IshraqueSarwar/fc_ee-26/references/MCU.jpg

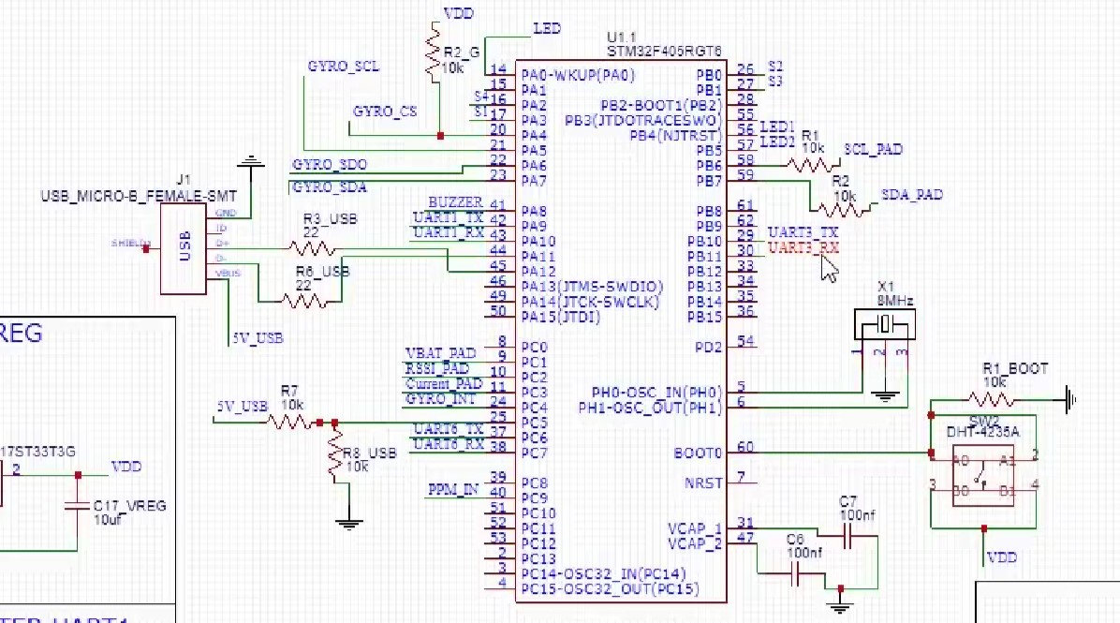
references/MCU.jpg
