IshraqueSarwar/fc_ee-26/references/9250-min-circuit.jpg

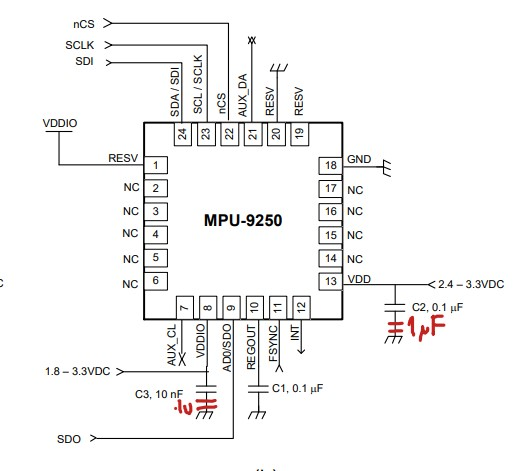
references/9250-min-circuit.jpg
