IshraqueSarwar/fc_ee-26/references/MCU_power.jpg

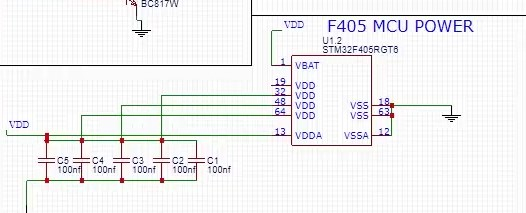
references/MCU_power.jpg
