IshraqueSarwar/fc_ee-26/references/MPU6000.jpg

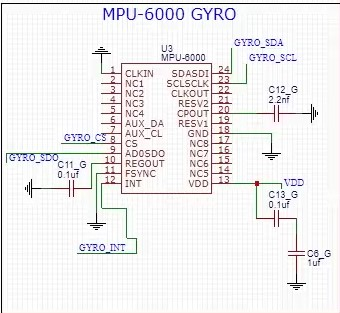
references/MPU6000.jpg
