IshraqueSarwar/fc_ee-26/references/STM32F407VET6_pin_def.jpg

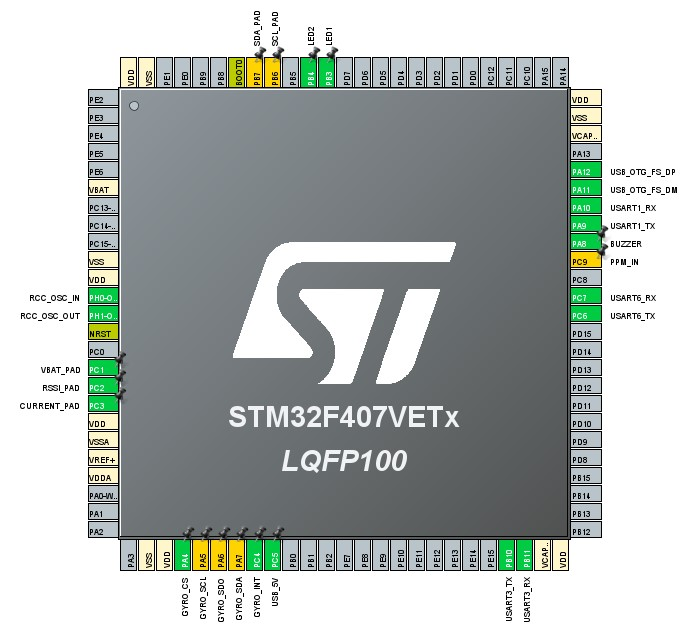
references/STM32F407VET6_pin_def.jpg
