IshraqueSarwar/fc_ee-26/schematics/fc-ee/fc-ee.kicad_pcb

## KiCad design schematics/fc-ee/fc-ee.kicad_pcb (2026-03-01)

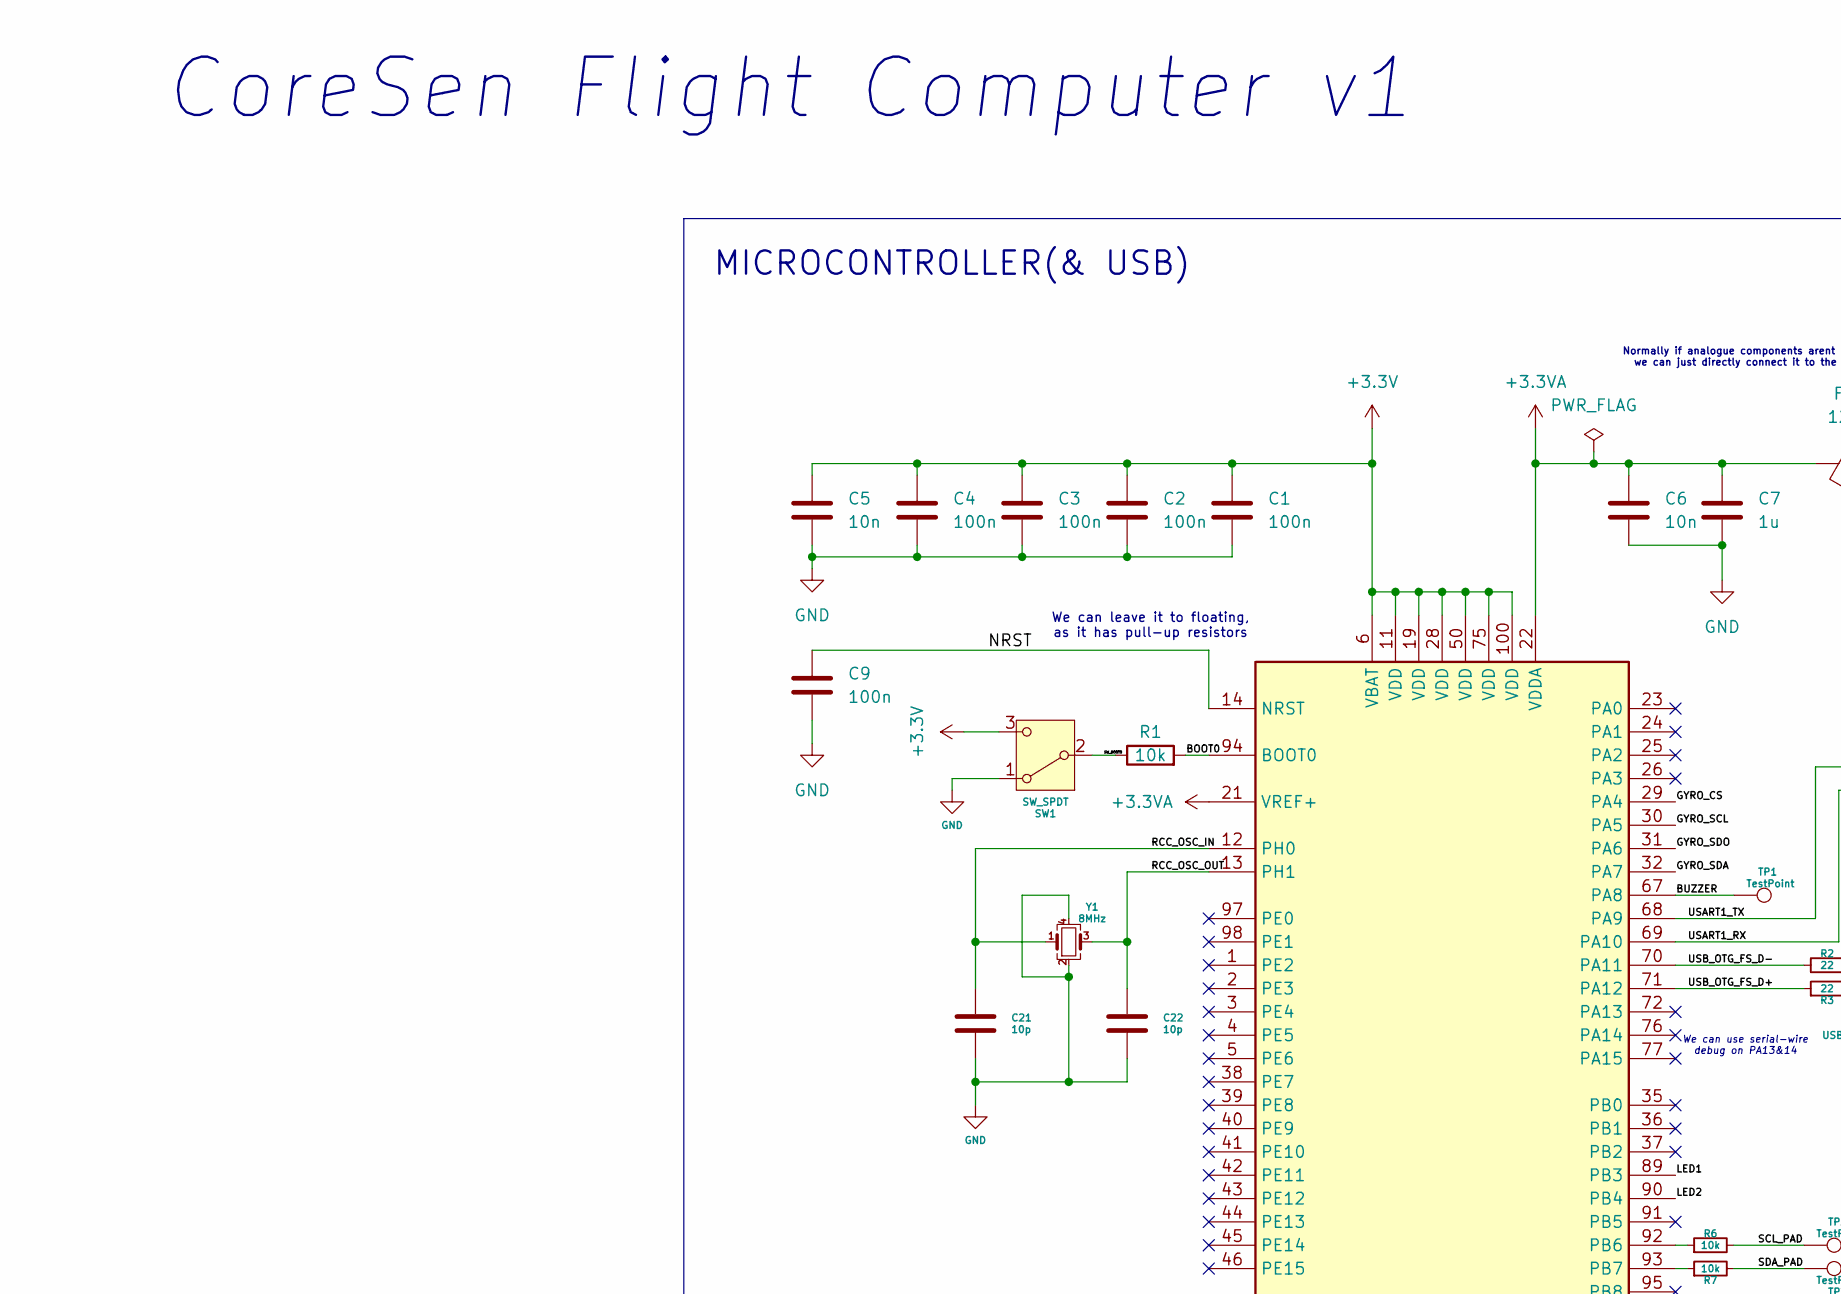
[picture p18: schematic fc-ee.kicad_sch, CoreSen-FC1, part in row 1, column 1]

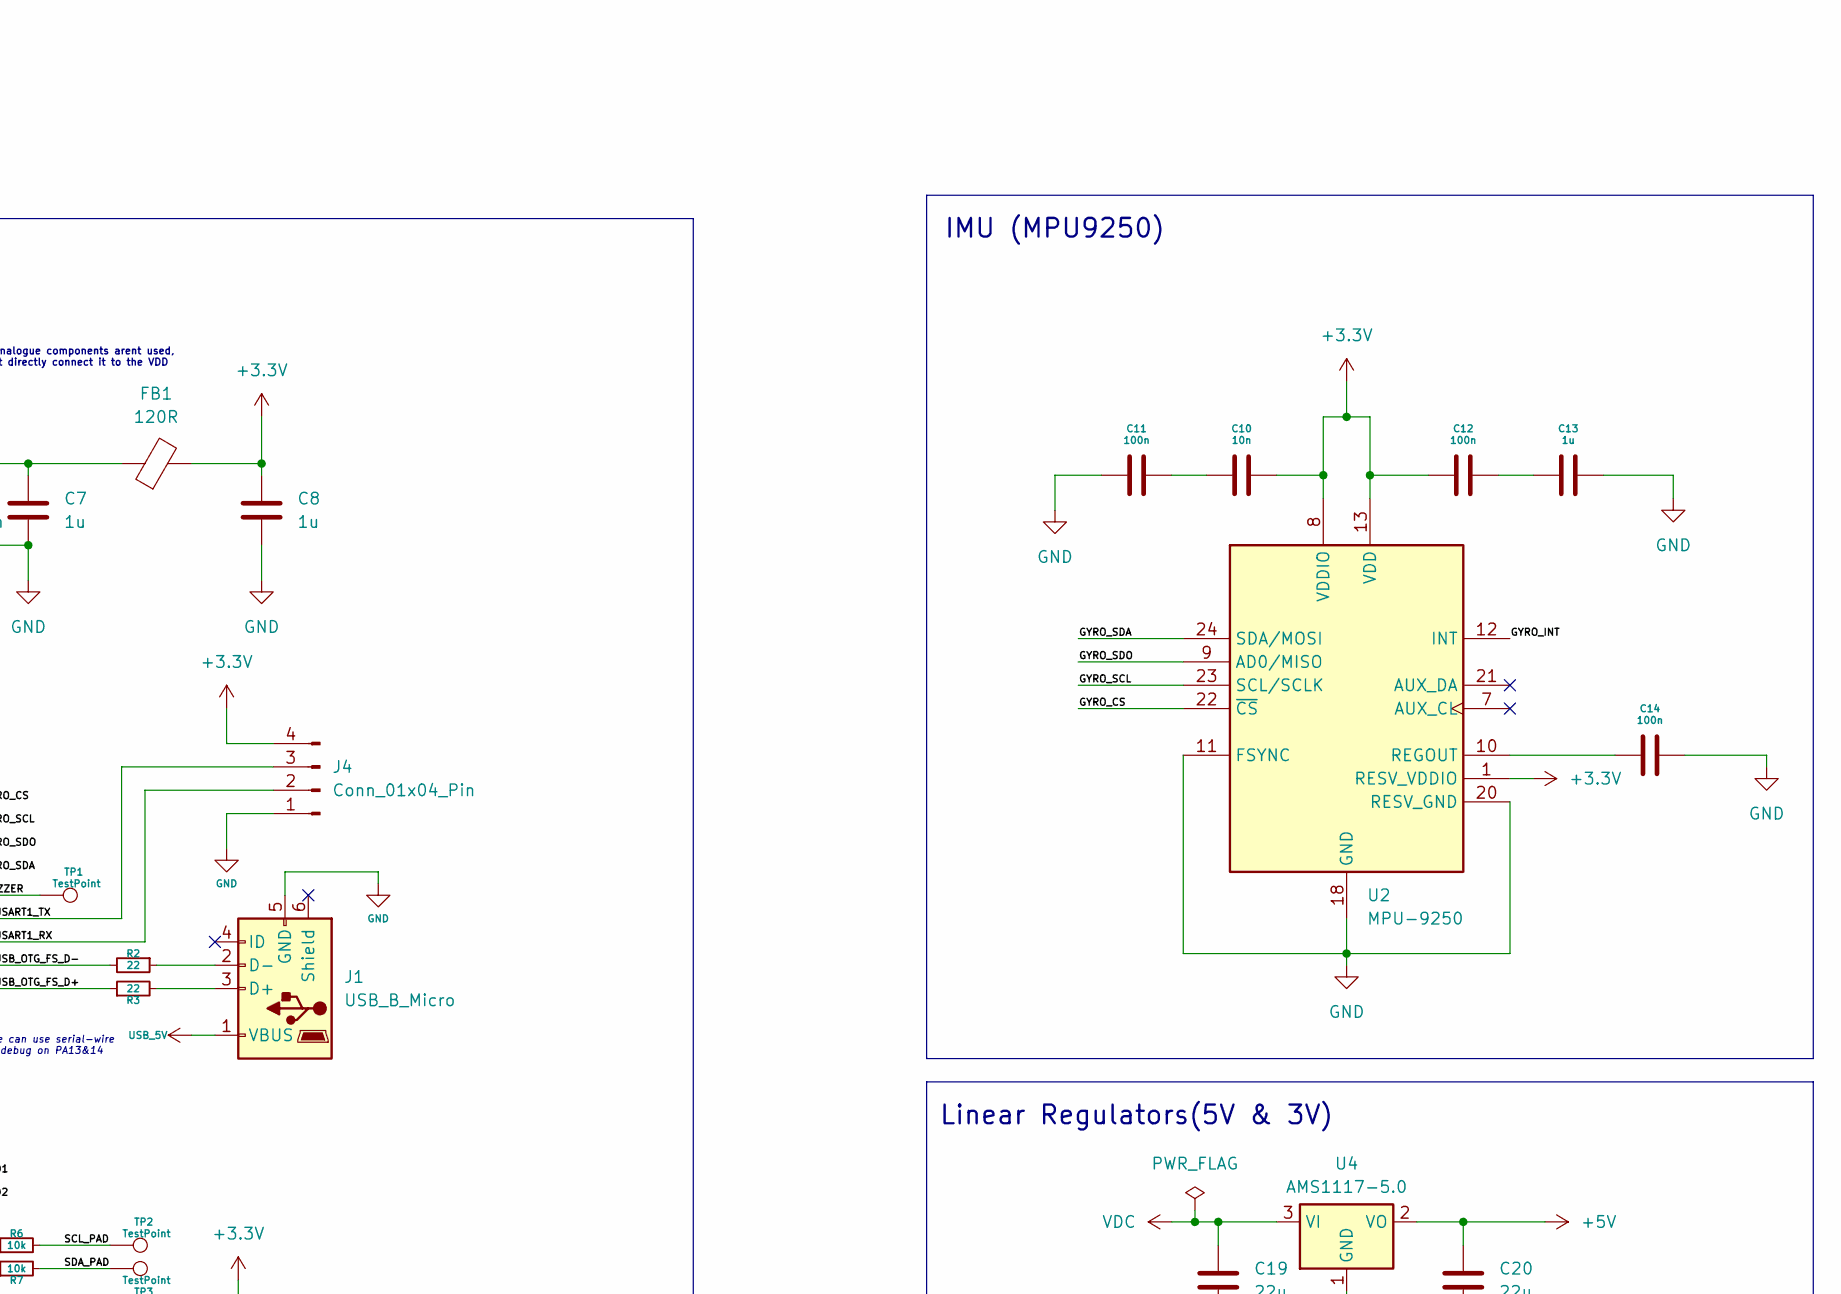
[picture p19: schematic fc-ee.kicad_sch, CoreSen-FC1, part in row 1, column 2]

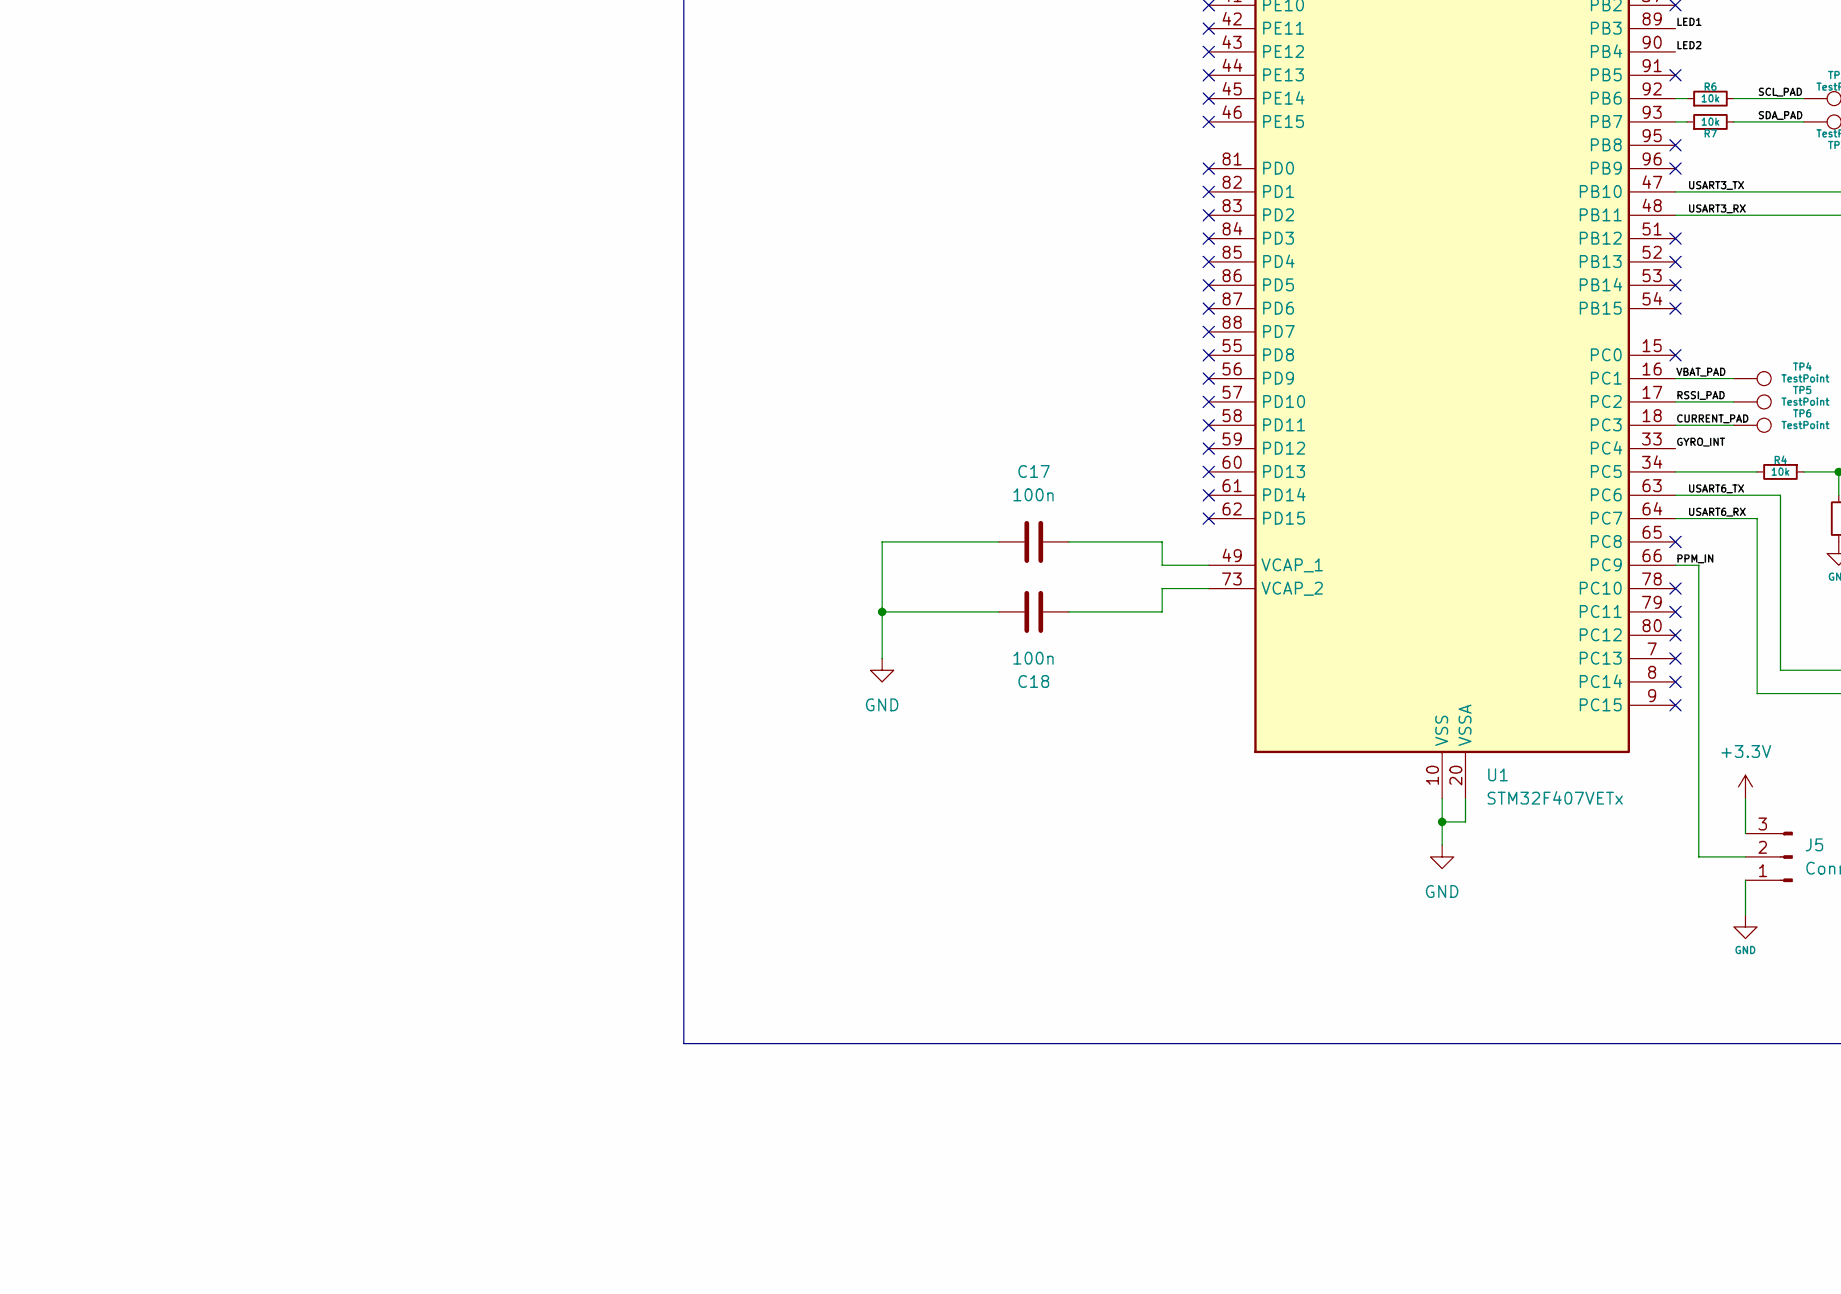
[picture p20: schematic fc-ee.kicad_sch, CoreSen-FC1, part in row 2, column 1]

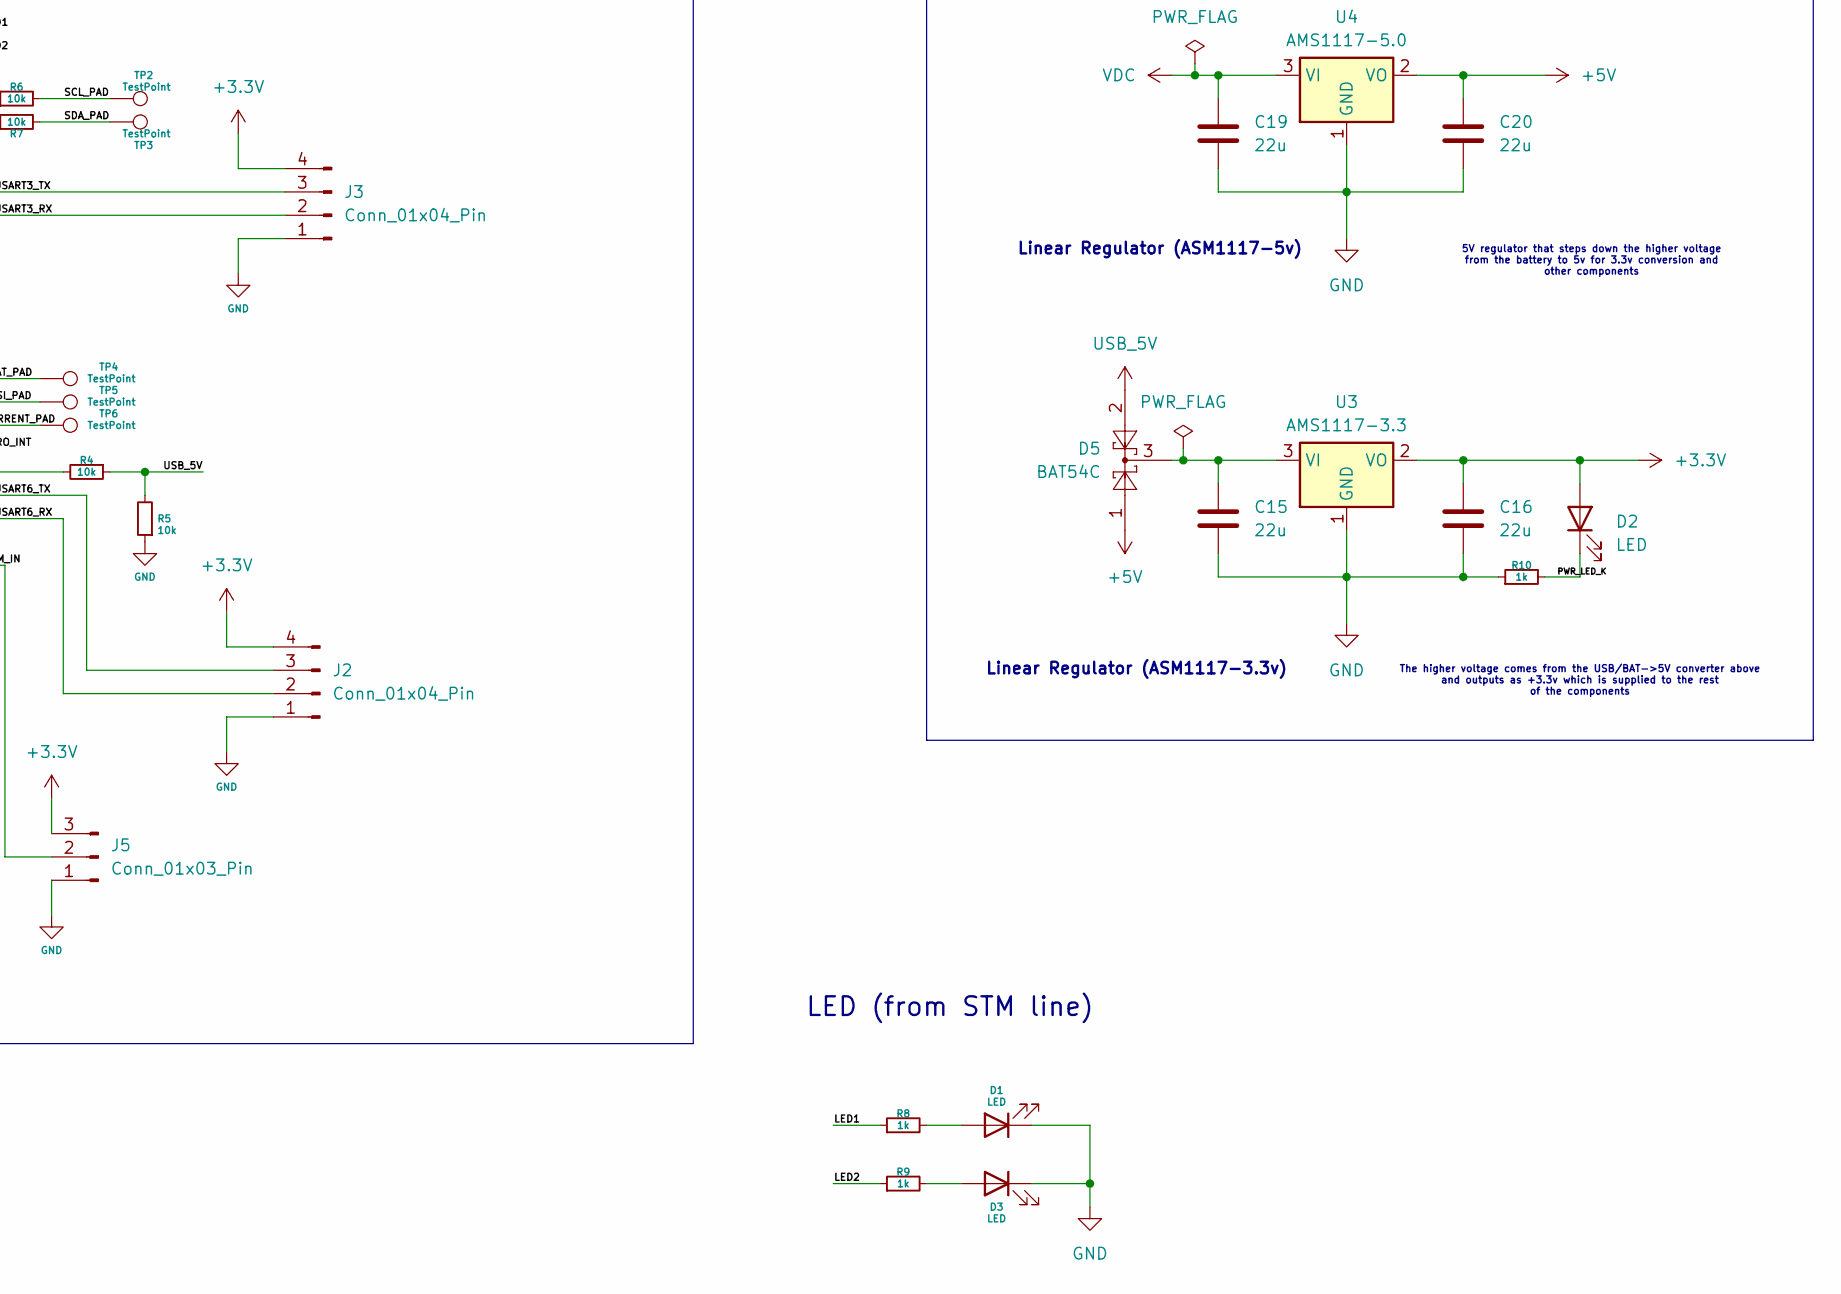
[picture p21: schematic fc-ee.kicad_sch, CoreSen-FC1, part in row 2, column 2]

Parts:
C1, C2, C3, C4, C9, C11, C12, C14, C17, C18: 100n; C_0402_1005Metric
C5, C6, C10: 10n; C_0603_1608Metric
C7, C8, C13: 1u; C_0402_1005Metric
C15, C16, C19, C20: 22u; C_0805_2012Metric
C21, C22: 10p; C_0603_1608Metric
D1, D2, D3: LED; LED_0201_0603Metric
D5: BAT54C; SOT-23
FB1: 120R; L_0603_1608Metric
J1: USB_B_Micro; USB_Micro-B_Molex_47346-0001
J2, J3, J4: Conn_01x04_Pin; PinHeader_1x04_P2.00mm_Vertical
J5: Conn_01x03_Pin; JST_NV_B03P-NV_1x03_P5.00mm_Vertical
R1, R4, R5, R6, R7: 10k; R_0402_1005Metric
R2, R3: 22; R_0402_1005Metric
R8, R9, R10: 1k; R_0402_1005Metric
SW1: SW_SPDT; SW_E-Switch_EG1224_SPDT_Angled
TP1, TP2, TP3, TP4, TP5, TP6: TestPoint; TestPoint_Pad_D4.0mm
U1: STM32F407VETx; LQFP-100_14x14mm_P0.5mm
U2: MPU-9250; InvenSense_QFN-24_3x3mm_P0.4mm
U3: AMS1117-3.3; SOT-223-3_TabPin2
U4: AMS1117-5.0; SOT-223-3_TabPin2
Y1: 8MHz; Crystal_SMD_3225-4Pin_3.2x2.5mm_HandSoldering

Connections:
+3.3V: C1.1, C2.1, C3.1, C4.1, C5.1, C8.1, C10.2, C12.1, C16.1, D2.2 (A), FB1.2, J2.4, J3.4, J4.4, J5.3, SW1.3 (C), U1.6 (VBAT), U1.11 (VDD), U1.19 (VDD), U1.28 (VDD), U1.50 (VDD), U1.75 (VDD), U1.100 (VDD), U2.1 (RESV_VDDIO), U2.8 (VDDIO), U2.13 (VDD), U3.2 (VO)
+3.3VA: C6.1, C7.1, FB1.1, U1.21 (VREF+), U1.22 (VDDA)
+5V: C20.1, D5.1, U4.2 (VO)
/BOOT0: R1.2, U1.94 (BOOT0)
/BUZZER: TP1.1, U1.67 (PA8)
/CURRENT_PAD: TP6.1, U1.18 (PC3)
/GYRO_CS: U1.29 (PA4), U2.22 (~CS)
/GYRO_INT: U1.33 (PC4), U2.12 (INT)
/GYRO_SCL: U1.30 (PA5), U2.23 (SCL/SCLK)
/GYRO_SDA: U1.32 (PA7), U2.24 (SDA/MOSI)
/GYRO_SDO: U1.31 (PA6), U2.9 (AD0/MISO)
/LED1: R8.1, U1.89 (PB3)
/LED2: R9.1, U1.90 (PB4)
/NRST: C9.1, U1.14 (NRST)
/PPM_IN: J5.2, U1.66 (PC9)
/PWR_LED_K: D2.1 (K), R10.2
/RCC_OSC_IN: C21.1, U1.12 (PH0), Y1.1
/RCC_OSC_OUT: C22.1, U1.13 (PH1), Y1.3
/RSSI_PAD: TP5.1, U1.17 (PC2)
/SCL_PAD: R6.2, TP2.1
/SDA_PAD: R7.2, TP3.1
/SW_BOOT0: R1.1, SW1.2 (B)
/USART1_RX: J4.2, U1.69 (PA10)
/USART1_TX: J4.3, U1.68 (PA9)
/USART3_RX: J3.2, U1.48 (PB11)
/USART3_TX: J3.3, U1.47 (PB10)
/USART6_RX: J2.2, U1.64 (PC7)
/USART6_TX: J2.3, U1.63 (PC6)
/USB_OTG_FS_D+: R3.1, U1.71 (PA12)
/USB_OTG_FS_D-: R2.2, U1.70 (PA11)
/VBAT_PAD: TP4.1, U1.16 (PC1)
GND: C1.2, C2.2, C3.2, C4.2, C5.2, C6.2, C7.2, C8.2, C9.2, C11.1, C13.2, C14.2, C15.2, C16.2, C17.1, C18.1, C19.2, C20.2, C21.2, C22.2, D1.1 (K), D3.1 (K), J1.5 (GND), J2.1, J3.1, J4.1, J5.1, R5.1, R10.1, SW1.1 (A), U1.10 (VSS), U1.20 (VSSA), U1.27 (VSS), U1.74 (VSS), U1.99 (VSS), U2.11 (FSYNC), U2.18 (GND), U2.20 (RESV_GND), U3.1 (GND), U4.1 (GND), Y1.2, Y1.4
unnamed: C10.1, C11.2
unnamed: C12.2, C13.1
unnamed: D1.2 (A), R8.2
unnamed: D3.2 (A), R9.2
unnamed: J1.3 (D+), R3.2
unnamed: J1.2 (D-), R2.1
unnamed: R6.1, U1.92 (PB6)
unnamed: R7.1, U1.93 (PB7)
unnamed: R4.2, U1.34 (PC5)
unnamed: C17.2, U1.49 (VCAP_1)
unnamed: C18.2, U1.73 (VCAP_2)
unnamed: C14.1, U2.10 (REGOUT)
unnamed: C15.1, D5.3, U3.3 (VI)
USB_5V: D5.2, J1.1 (VBUS), R4.1, R5.2
VDC: C19.1, U4.3 (VI)

Notes on the sheet:
Linear Regulators(5V & 3V)
We can leave it to floating, as it has pull-up resistors
We can use serial-wire debug on PA13&14
IMU (MPU9250)
The higher voltage comes from the USB/BAT->5V converter above and outputs as +3.3v which is supplied to the rest of the components
Normally if analogue components arent used, we can just directly connect it to the VDD
MICROCONTROLLER(& USB)
5V regulator that steps down the higher voltage from the battery to 5v for 3.3v conversion and other components
LED (from STM line)
Linear Regulator (ASM1117-3.3v)
CoreSen Flight Computer v1
Linear Regulator (ASM1117-5v)

Board: 2 copper layers, 54 parts (0 on the bottom side), 47 nets, no tracks yet.
