IshraqueSarwar/fc_ee-26/program/program.ioc

Mcu.UserName=STM32F407VETx
PA10.Signal=USART1_RX
PA11.Signal=USB_OTG_FS_DM
PA12.Signal=USB_OTG_FS_DP
PA4.GPIO_Label=GYRO_CS
PA4.Signal=GPIO_Output
PA5.GPIO_Label=GYRO_SCL
PA5.Signal=SPI1_SCK
PA6.GPIO_Label=GYRO_SDO
PA6.Signal=SPI1_MISO
PA7.GPIO_Label=GYRO_SDA
PA7.Signal=SPI1_MOSI
PA8.GPIO_Label=BUZZER
PA8.Signal=GPIO_Output
PA9.Signal=USART1_TX
PB10.Signal=USART3_TX
PB11.Signal=USART3_RX
PB3.GPIO_Label=LED1
PB3.Signal=GPIO_Output
PB4.GPIO_Label=LED2
PB4.Signal=GPIO_Output
PB6.GPIO_Label=SCL_PAD
PB6.Signal=I2C1_SCL
PB7.GPIO_Label=SDA_PAD
PB7.Signal=I2C1_SDA
PC1.GPIO_Label=VBAT_PAD
PC1.Signal=ADCx_IN11
PC2.GPIO_Label=RSSI_PAD
PC2.Signal=ADCx_IN12
PC3.GPIO_Label=CURRENT_PAD
PC3.Signal=ADCx_IN13
PC4.GPIO_Label=GYRO_INT
PC4.Signal=GPXTI4
PC5.GPIO_Label=USB_5V
PC5.Signal=ADCx_IN15
PC6.Signal=USART6_TX
PC7.Signal=USART6_RX
PC9.GPIO_Label=PPM_IN
PC9.Signal=S_TIM3_CH4
PH0-OSC_IN.Signal=RCC_OSC_IN
PH1-OSC_OUT.Signal=RCC_OSC_OUT
