IshraqueSarwar/fc_ee-26/program/Core/Inc/main.h

#define GYRO_CS_Pin GPIO_PIN_4
#define GYRO_CS_GPIO_Port GPIOA
#define GYRO_SDO_Pin GPIO_PIN_6
#define GYRO_SDO_GPIO_Port GPIOA
#define GYRO_SDA_Pin GPIO_PIN_7
#define GYRO_SDA_GPIO_Port GPIOA
#define BUZZER_Pin GPIO_PIN_8
#define BUZZER_GPIO_Port GPIOA
#define LED1_Pin GPIO_PIN_4
#define LED1_GPIO_Port GPIOB
#define LED2_Pin GPIO_PIN_5
#define LED2_GPIO_Port GPIOB
#define SDA_PAD_Pin GPIO_PIN_6
#define SDA_PAD_GPIO_Port GPIOB
#define SCL_PAD_Pin GPIO_PIN_7
#define SCL_PAD_GPIO_Port GPIOB
