IshraqueSarwar/fc_ee-26/(commit log)

2026-02-22 update 2/22/26
    [fc-ee.kicad_pcb, fc-ee.kicad_sch]
2026-02-25 update 2/25/26
    [fc-ee.kicad_sch]
2026-02-26 update 2/26/26
    [fc-ee.kicad_sch]
